pixelmatix/SmartMatrix-Apa102-Shield-Photon/SmartMatrixPhotonApa_bom_V1.xlsx

RefDes | Name | Qty | RoHS | Notes | Digikey | Manufacturer | Part# | Alt Source
C1 | CAP CER 0.1UF 10V 10% X7R 0603 | 1 | X |  | 399-1095-1-ND | Any
C2 | CAP CER 10UF 10V 10% X7R 0805 | 1 | X |  | 490-10517-1-ND | Any
R1 | RES SMD 47K OHM 1% 1/10W 0603 | 1 | X |  | 1276-5102-1-ND | Any
IC1, IC2 | SN74AHCT1G08 SOT-23-5 | 2 | X |  | 296-1113-1-ND | TI | SN74AHCT1G08DBVR
D1 | DIODE SCHOTTKY 20V 500MA SOD123 | 1 | X |  | MBR0520LT3GOSCT-ND | ON Semi | MBR0520LT3G
U1 | microSD Socket | 1 | X |  | 101-00660-68-6-1-ND | Amphenol | 101-00660-68-6 | 4UCon 15882 - https://www.sparkfun.com/products/127
JP3,JP4 | 2x12 SMT 0.1" Socket | 2 | X |  |  | 4UCon | 13111 | Samtec SSM-112-F-DV-BE
JP2 | 1x2 SMT 0.1" pins | 1 | X |  |  | 4UCon | 13402 | Samtec TSM-102-01-T-SH
DNP
JP1 | (optional) 4-pin terminal block |  |  |  |  | Kaweei | KF120-4P | 4UCon 20087 - https://www.adafruit.com/products/2137
J1 | 0 OHM 0603
R2 | 47K 0603
C3 | CAP CER 100UF 6.3V X5R
