pixelmatix/SmartMatrix-Apa102-Shield-Photon/SmartMatrixPhotonApa_brd.pdf

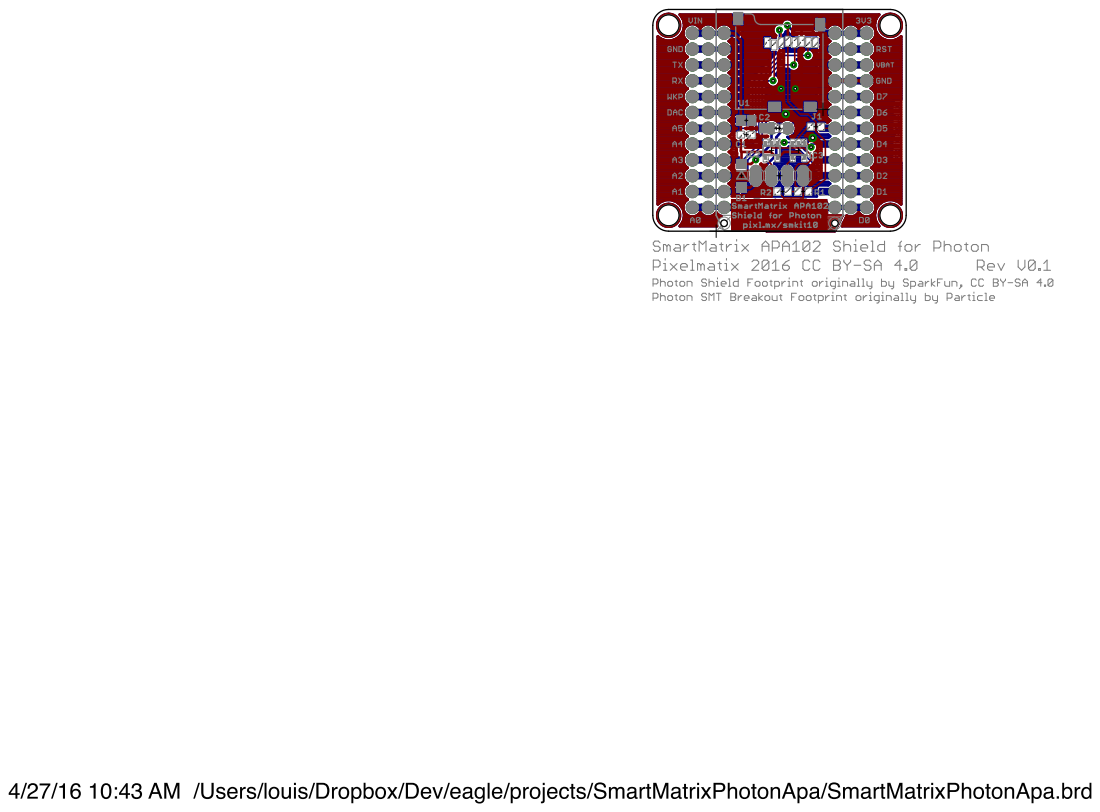
[picture p1: page 1]
