pixelmatix/SmartMatrix-Apa102-Shield-Photon/SmartMatrixPhotonApa_sch.pdf

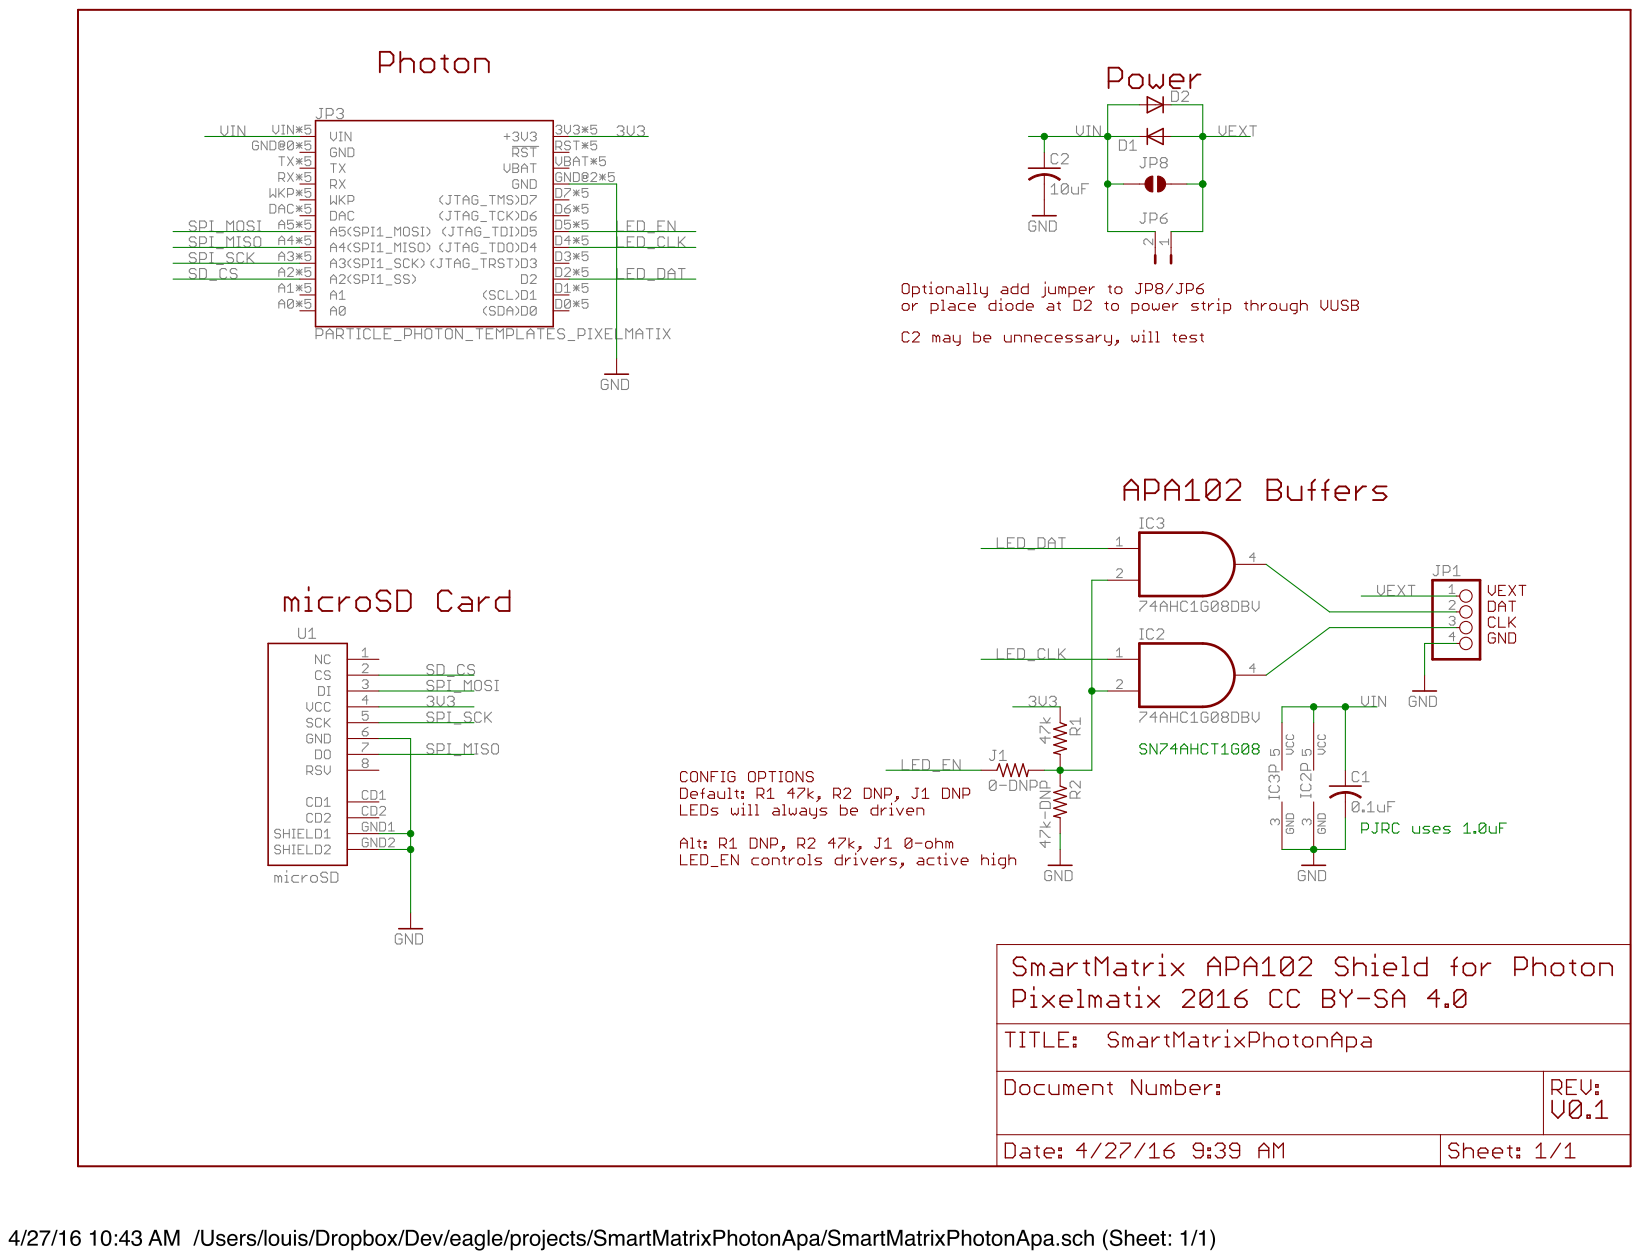
[picture p2: page 1]
