pixelmatix/SmartMatrix-Apa102-Shield-Photon/SmartMatrixPhotonApa_V1.brd

## EAGLE design SmartMatrixPhotonApa_V1.brd (2016-07-07)

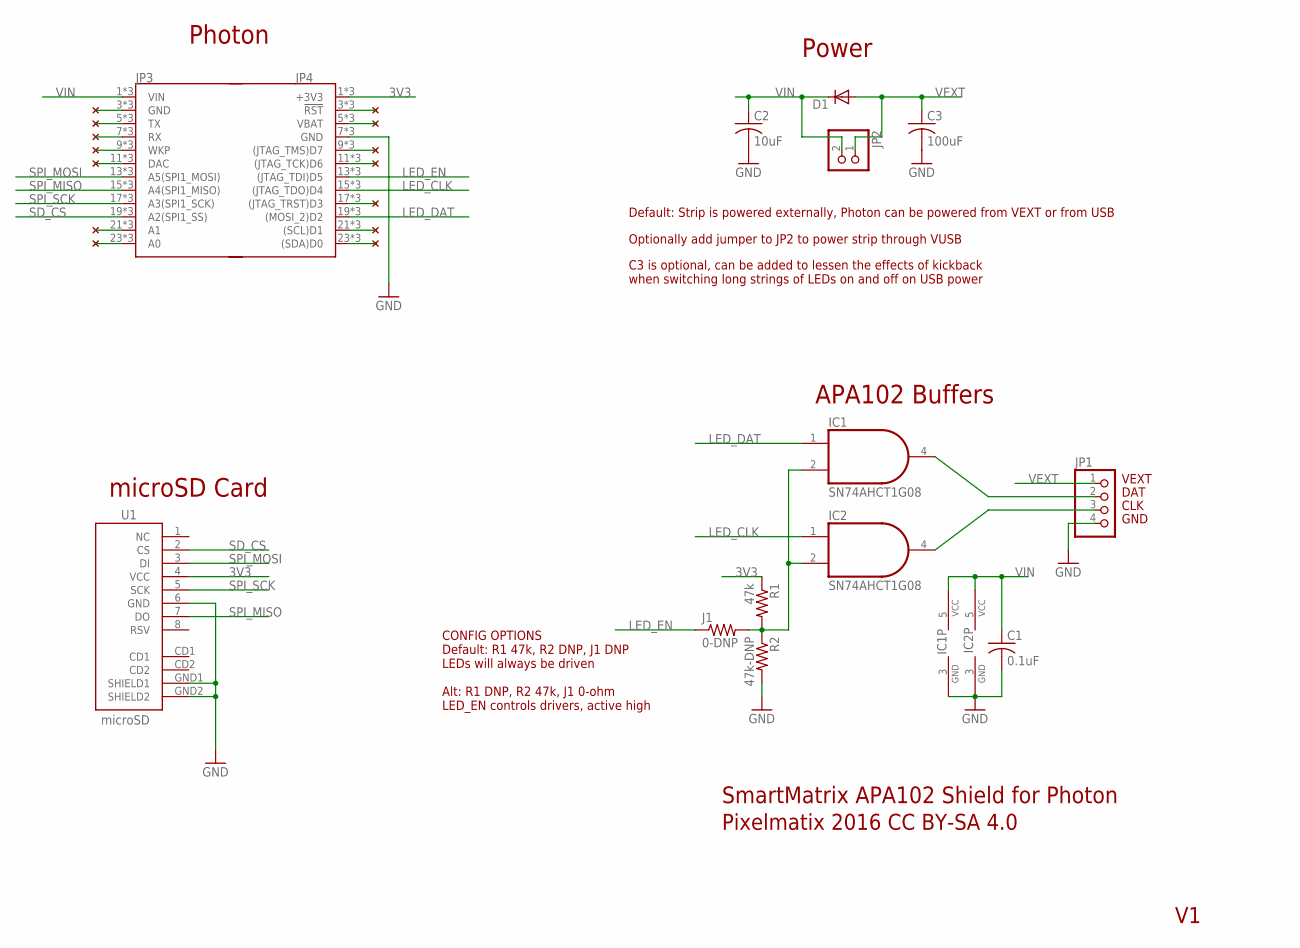
[picture p3: schematic SmartMatrixPhotonApa_V1.sch]

Parts:
C1: 0.1uF; C0603; PARTNO CAP CER 0.1UF 10V 10% X7R 0805
C2: 10uF; C0805; PARTNO CAP CER 0.1UF 10V 10% X7R 0805
C3: 100uF; C1206; PARTNO CAP CER 0.1UF 10V 10% X7R 0805
D1: MBR0520LT; SOD123
IC1, IC2: 74AHC1G08DBV; SOT23-5
J1: 0-DNP; R0603
JP1: PINHD-1X04_2.54LARGE; 1X04-LARGEHOLE
JP2: PINHD-1X02_2.54-SMD-90°; 1X02SMD/90
JP3: 2x12 Female SMT Socket; PHOTON_DUAL_HEADER_SHIELD_BOT_MOUNT_LEFT
JP4: 2x12 Female SMT Socket; PHOTON_DUAL_HEADER_SHIELD_BOT_MOUNT_RIGHT
R1: 47k; R0603
R2: 47k-DNP; R0603
U1: microSD; MICRO-SD-SOCKET-PP

Connections:
3V3: JP4.1 (+3V3), JP4.2 (+3V3), JP4.3V3 (+3V3), R1.1, U1.4 (VCC)
CLK: IC2.4 (O), JP1.3
DAT: IC1.4 (O), JP1.2
GND: C1.2, C2.2, C3.2, IC1.3 (GND), IC2.3 (GND), JP1.4, JP4.7 (GND), JP4.8 (GND), JP4.GND@2 (GND), R2.2, U1.6 (GND), U1.GND1 (SHIELD1), U1.GND2 (SHIELD2)
LED_CLK: IC2.1 (I0), JP4.15 ((JTAG_TDO)D4), JP4.16 ((JTAG_TDO)D4), JP4.D4 ((JTAG_TDO)D4)
LED_DAT: IC1.1 (I0), JP4.19 ((MOSI_2)D2), JP4.20 ((MOSI_2)D2), JP4.D2 ((MOSI_2)D2)
LED_EN: J1.1, JP4.13 ((JTAG_TDI)D5), JP4.14 ((JTAG_TDI)D5), JP4.D5 ((JTAG_TDI)D5)
unnamed: JP3.3 (GND), JP3.4 (GND), JP3.GND@0 (GND)
unnamed: JP3.5 (TX), JP3.6 (TX), JP3.TX
unnamed: JP3.7 (RX), JP3.8 (RX), JP3.RX
unnamed: IC1.2 (I1), IC2.2 (I1), J1.2, R1.2, R2.1
unnamed: JP3.9 (WKP), JP3.10 (WKP), JP3.WKP
unnamed: JP3.11 (DAC), JP3.12 (DAC), JP3.DAC
unnamed: JP3.21 (A1), JP3.22 (A1), JP3.A1
unnamed: JP3.23 (A0), JP3.24 (A0), JP3.A0
unnamed: JP4.3 (!RST!), JP4.4 (!RST!), JP4.RST (!RST!)
unnamed: JP4.5 (VBAT), JP4.6 (VBAT), JP4.VBAT
unnamed: JP4.9 ((JTAG_TMS)D7), JP4.10 ((JTAG_TMS)D7), JP4.D7 ((JTAG_TMS)D7)
unnamed: JP4.11 ((JTAG_TCK)D6), JP4.12 ((JTAG_TCK)D6), JP4.D6 ((JTAG_TCK)D6)
unnamed: JP4.17 ((JTAG_TRST)D3), JP4.18 ((JTAG_TRST)D3), JP4.D3 ((JTAG_TRST)D3)
unnamed: JP4.21 ((SCL)D1), JP4.22 ((SCL)D1), JP4.D1 ((SCL)D1)
unnamed: JP4.23 ((SDA)D0), JP4.24 ((SDA)D0), JP4.D0 ((SDA)D0)
SD_CS: JP3.19 (A2(SPI1_SS)), JP3.20 (A2(SPI1_SS)), JP3.A2 (A2(SPI1_SS)), U1.2 (CS)
SPI_MISO: JP3.15 (A4(SPI1_MISO)), JP3.16 (A4(SPI1_MISO)), JP3.A4 (A4(SPI1_MISO)), U1.7 (DO)
SPI_MOSI: JP3.13 (A5(SPI1_MOSI)), JP3.14 (A5(SPI1_MOSI)), JP3.A5 (A5(SPI1_MOSI)), U1.3 (DI)
SPI_SCK: JP3.17 (A3(SPI1_SCK)), JP3.18 (A3(SPI1_SCK)), JP3.A3 (A3(SPI1_SCK)), U1.5 (SCK)
VEXT: C3.1, D1.A, JP1.1, JP2.1
VIN: C1.1, C2.1, D1.C, IC1.5 (VCC), IC2.5 (VCC), JP2.2, JP3.1 (VIN), JP3.2 (VIN), JP3.VIN

Notes on the sheet:
SN74AHCT1G08
VEXT
CLK
GND
DAT
CONFIG OPTIONS Default: R1 47k, R2 DNP, J1 DNP LEDs will always be driven Alt: R1 DNP, R2 47k, J1 0-ohm LED_EN controls drivers, active high
Optionally add jumper to JP2 to power strip through VUSB
SmartMatrix APA102 Shield for Photon
Pixelmatix 2016 CC BY-SA 4.0
Photon
Power
APA102 Buffers
microSD Card
C3 is optional, can be added to lessen the effects of kickback when switching long strings of LEDs on and off on USB power
Default: Strip is powered externally, Photon can be powered from VEXT or from USB

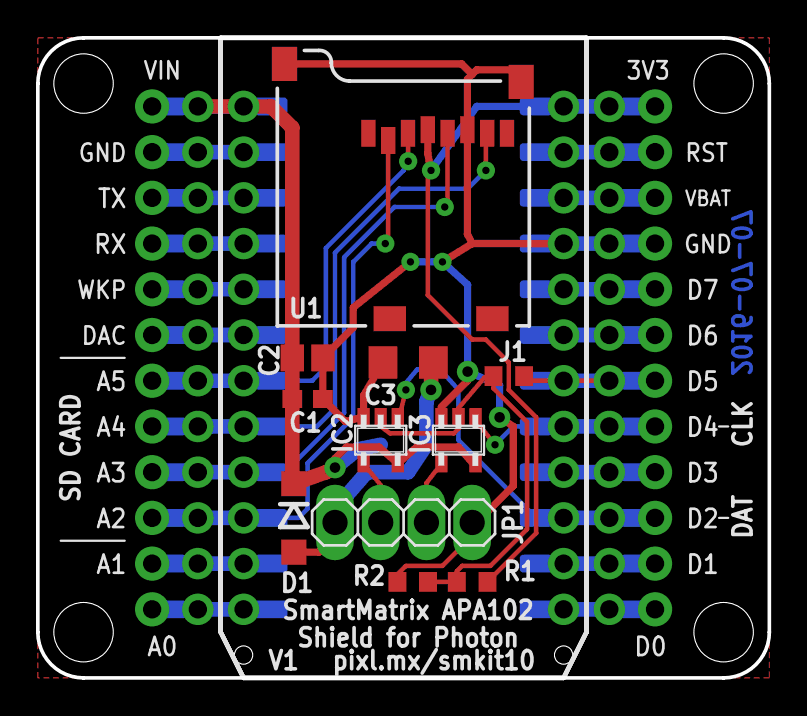
[picture p4: board SmartMatrixPhotonApa_V1.brd from above]

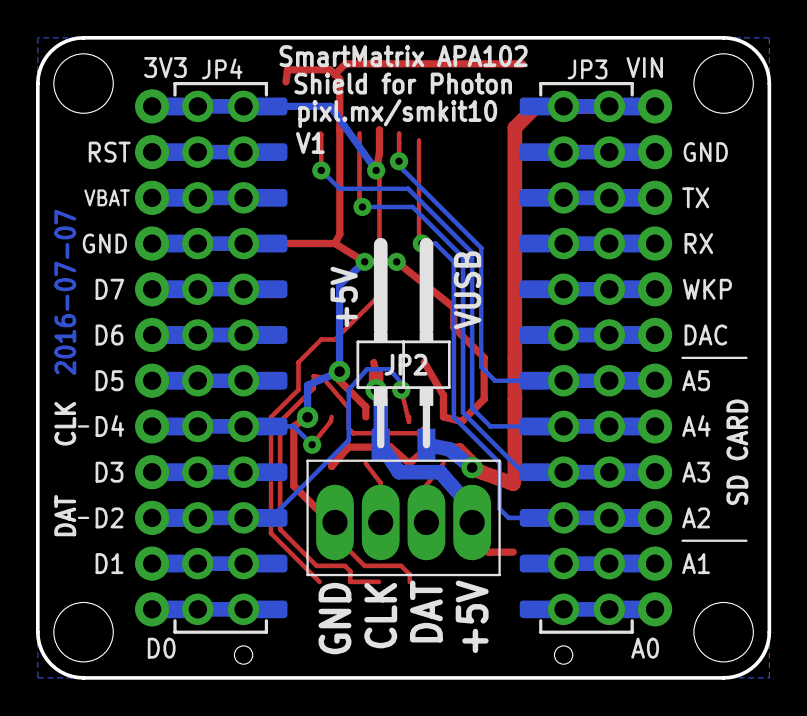
[picture p5: board SmartMatrixPhotonApa_V1.brd from below]

Board: 2 copper layers, 40.6 x 35.6 mm, 14 parts (3 on the bottom side), 28 nets.
