pixelmatix/SmartMatrix-Apa102-Shield-Photon/(commit log)

2016-04-19 Schematic cleaned up, mostly done, one todo
    [SmartMatrixPhotonApa.brd, SmartMatrixPhotonApa.sch]
2016-04-19 Rough routing of board, not close to passing DRC
    [SmartMatrixPhotonApa.brd, SmartMatrixPhotonApa.sch]
2016-04-27 Rev V0.1, ready to order prototypes
    [SmartMatrixPhotonApa.brd, SmartMatrixPhotonApa.sch]
2016-04-27 Add BOM
    [SmartMatrixPhotonApa_bom.xlsx]
2016-04-27 Add implied "1" quantities
    [SmartMatrixPhotonApa_bom.xlsx]
2016-07-07 Changes for V1 - Larger holes for APA102 wires - a 1x2 SMT jumper on bottom side of board for VIN and VEXT - optional (DNP) 6.3V 100uF smd 1206 cap to shield to help with USB power kickback when long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
    [SmartMatrixPhotonApa.brd, SmartMatrixPhotonApa.sch, SmartMatrixPhotonApa_bom.xlsx]
2016-07-07 Added Eagle files with V1 name and gerbers
    [SmartMatrixPhotonApa_V1.GBL, SmartMatrixPhotonApa_V1.GBO, SmartMatrixPhotonApa_V1.GBP, SmartMatrixPhotonApa_V1.GBS, SmartMatrixPhotonApa_V1.GKO, SmartMatrixPhotonApa_V1.GTL, SmartMatrixPhotonApa_V1.GTO, SmartMatrixPhotonApa_V1.GTP]
