pixelmatix/SmartMatrix-Apa102-Shield-Photon/(notices)

Notices in the files:
SmartMatrixPhotonApa_V1.brd:
Photon Shield Footprint originally by SparkFun, CC BY-SA 4.0
